meyerml/Studienarbeit/readme.md

# ESP-basierte Funkklingel

In diesem Projekt werden verschiedene ESP32-basierte Hardwareplattformen auf minimalen Deep-Sleep-Strom getestet. Einige Modifizierungen wurden an den Hardwareplattformen vorgenommen, um den Deep-Sleep-Strom weiter zu reduzieren. Desweiteren wurden verschiedene Wireless-Protokolle gestestet und auf ihren Energieverbrauch hin untersucht.

Mit diesen Tools können Mp3-Dateien für den M5Stack Atom Echo spielbar gemacht werden:

mp3 -> pcm: https://products.aspose.app/slides/de/video/mp3-to-pcm#google\_vignette

pcm -> c Array: https://notisrac.github.io/FileToCArray/
