meyerml/Studienarbeit/deep_sleep/hardware.ods

ohne vcc supervisory circuit | 9.8
ohne led | 9.39
ohne coprozessor | 0.213
 |  | 33µA
ohne led |  | 23µA
ohne LCD driver |  | 10mA?
ohne opamp |  | 21.8
 |  |  | 469.24
ohne LED |  |  | 108.6µA
ohne sensor |  |  | 108.6µA
 |  |  | 52µA
