meyerml/Studienarbeit/wireless_protocols/boot/ppk-20260218T080058.png

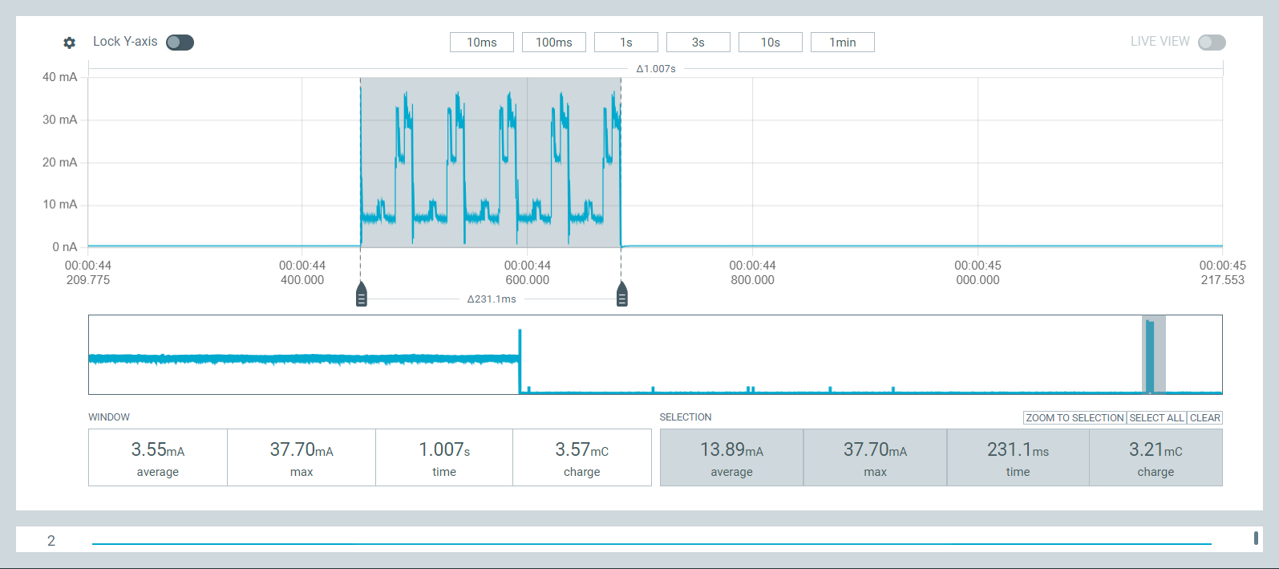
wireless_protocols/boot/ppk-20260218T080058.png
