meyerml/Studienarbeit/wireless_protocols/boot_wifi/ppk-20260218T075423.png

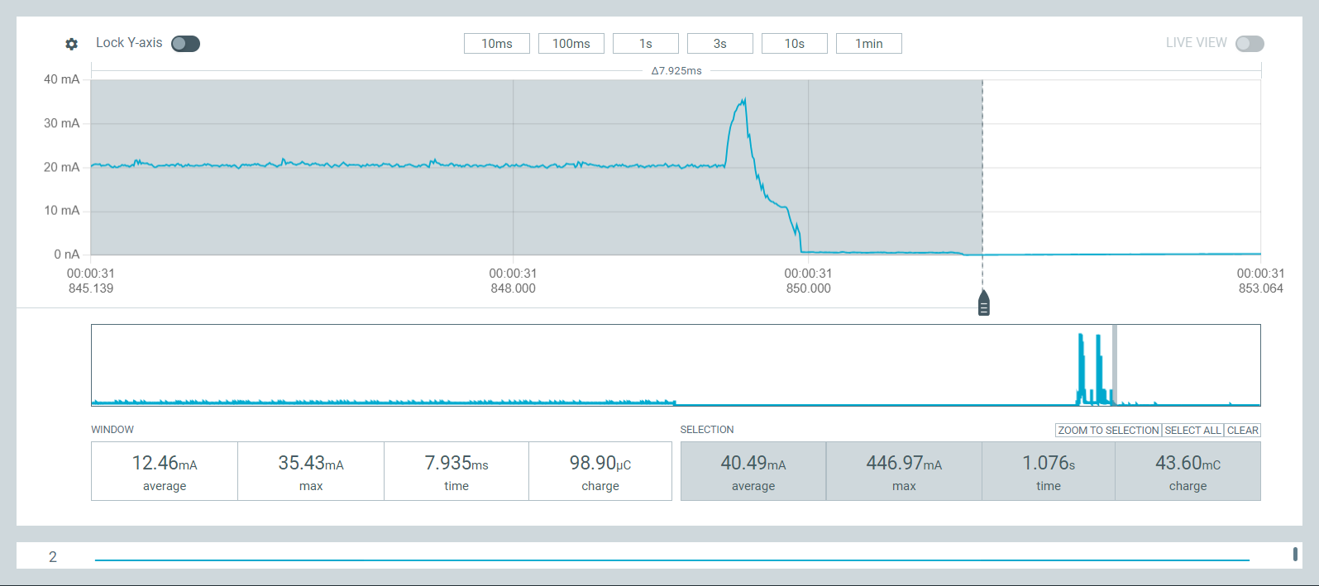
wireless_protocols/boot_wifi/ppk-20260218T075423.png
