meyerml/Studienarbeit/wireless_protocols/current_consumption_plot.png

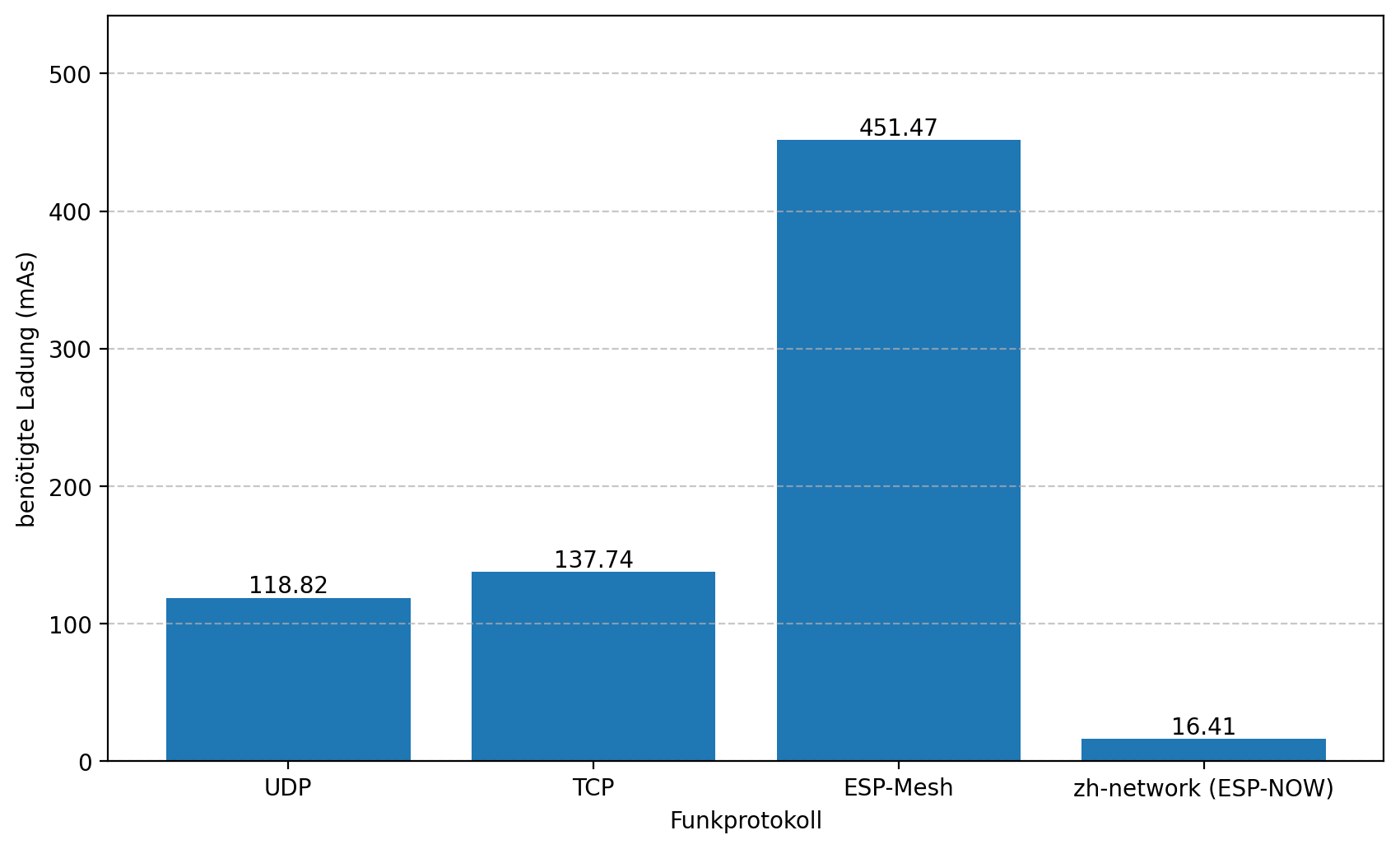
wireless_protocols/current_consumption_plot.png
