meyerml/Studienarbeit/wireless_protocols/ESP-Mesh/ppk-20260211T094203.png

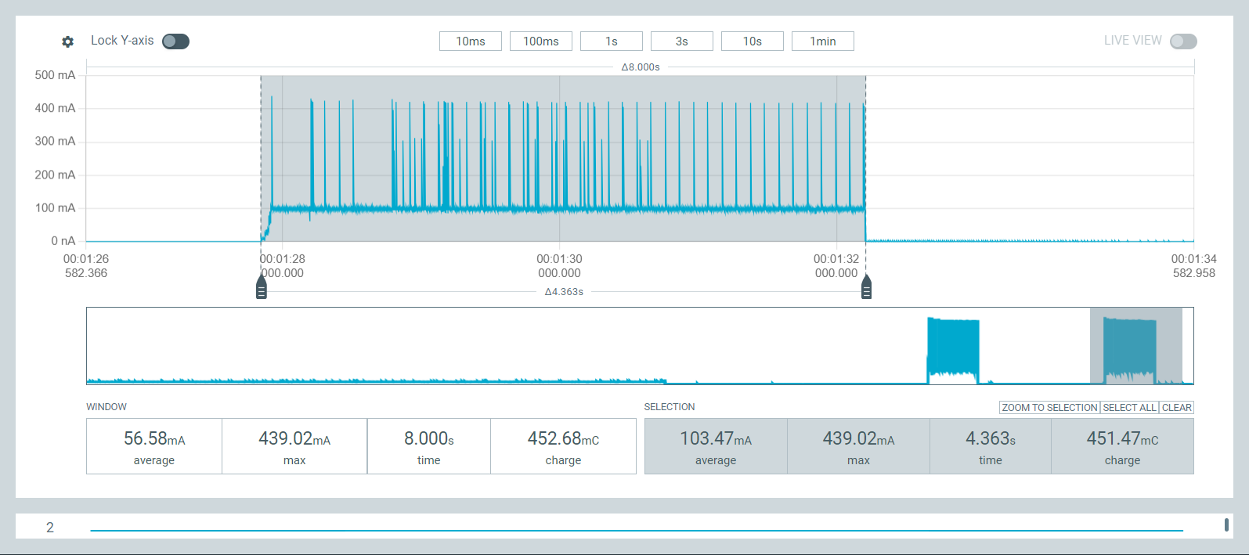
wireless_protocols/ESP-Mesh/ppk-20260211T094203.png
