meyerml/Studienarbeit/wireless_protocols/plot.png

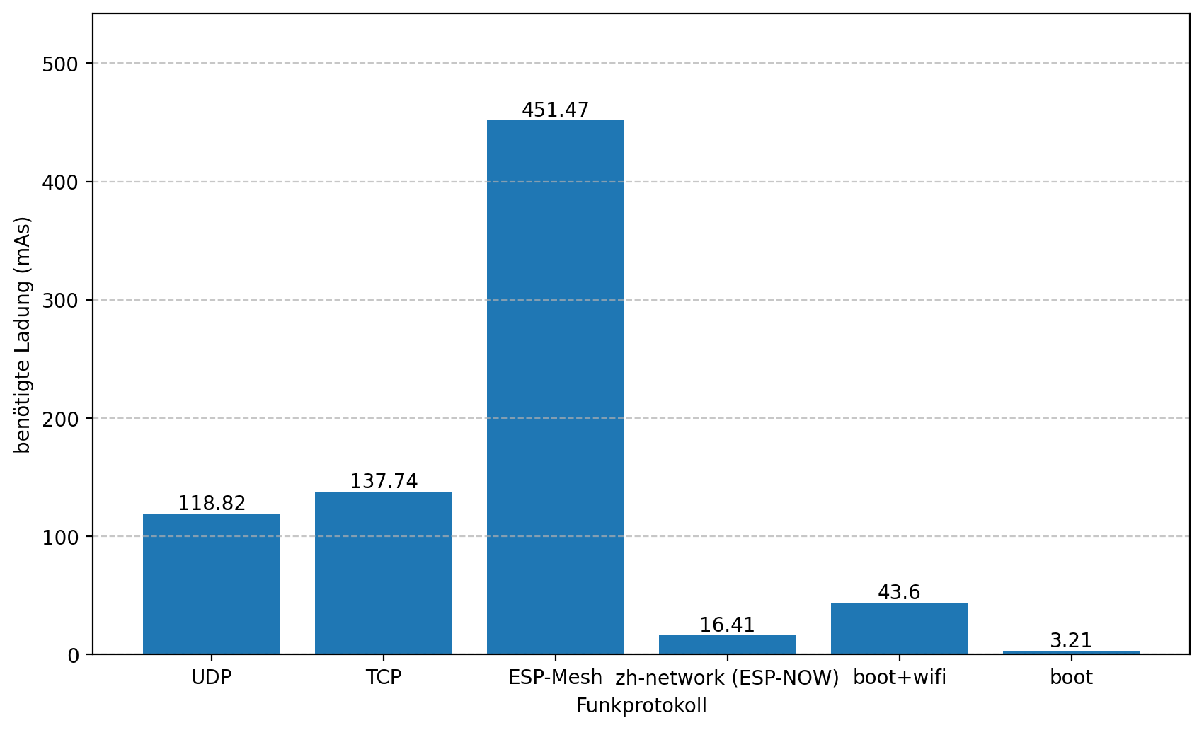
wireless_protocols/plot.png
