meyerml/Studienarbeit/wireless_protocols/TCP/ppk-20260210T215253.png

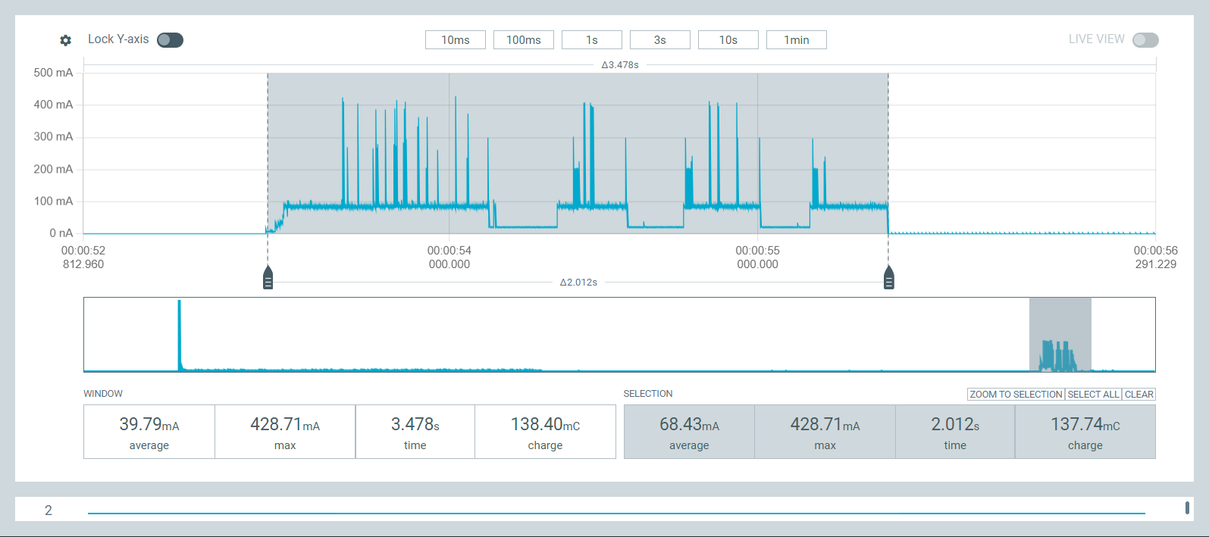
wireless_protocols/TCP/ppk-20260210T215253.png
