meyerml/Studienarbeit/wireless_protocols/UDP/sending.png

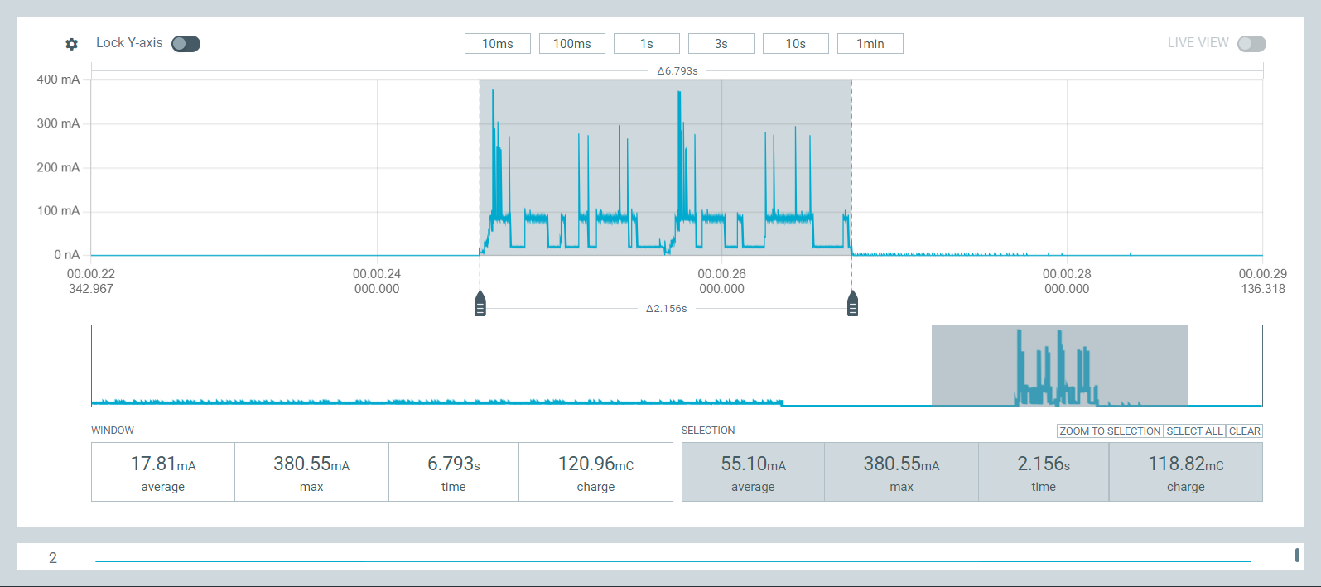
wireless_protocols/UDP/sending.png
