meyerml/Studienarbeit/wireless_protocols/measurements.ods

 | atom lite | codecell
deep sleep current
 | thread | zigbee | udp | tcp | Esp-mesh | Esp-now mesh | only boot + wifi | only boot
charge for sending ring | 207.49 | 55.82mC | 118.82mC | 137.74mC | 451.47mC | 16.41mC | 43.6mC | 3.21mC
