meyerml/Studienarbeit/deep_sleep/deep_sleep_baseline_measurements/atom/deepsleepcurrent.png

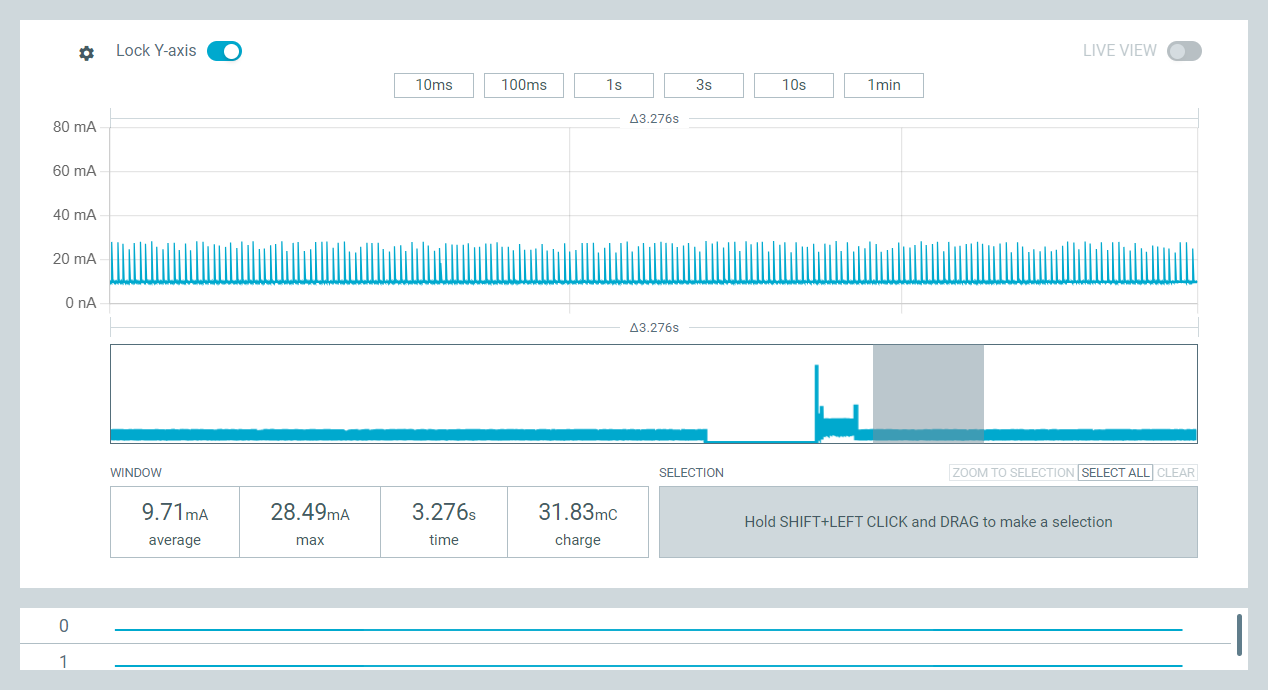
deep_sleep/deep_sleep_baseline_measurements/atom/deepsleepcurrent.png
