meyerml/Studienarbeit/deep_sleep/deep_sleep_baseline_measurements/atom/deepsleepcurrent_vs_nondeepsleep.png

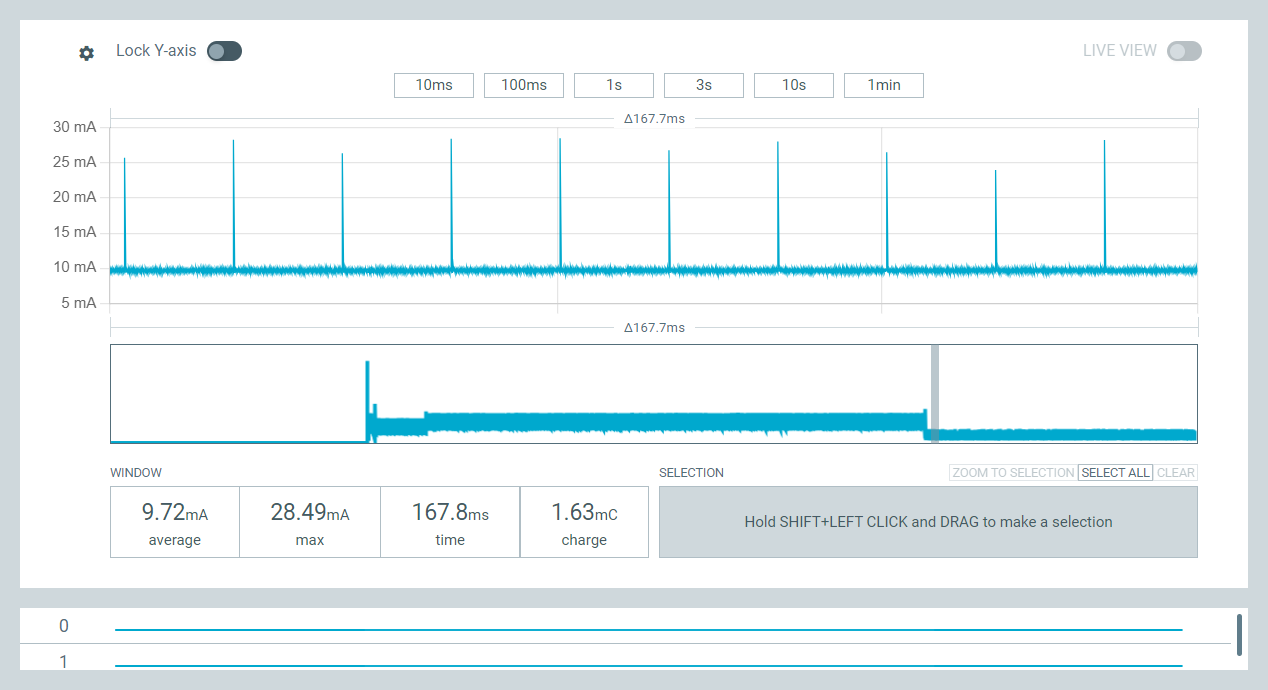
deep_sleep/deep_sleep_baseline_measurements/atom/deepsleepcurrent_vs_nondeepsleep.png
