meyerml/Studienarbeit/deep_sleep/deep_sleep_baseline_measurements/atom/nondeepsleep_detail.png

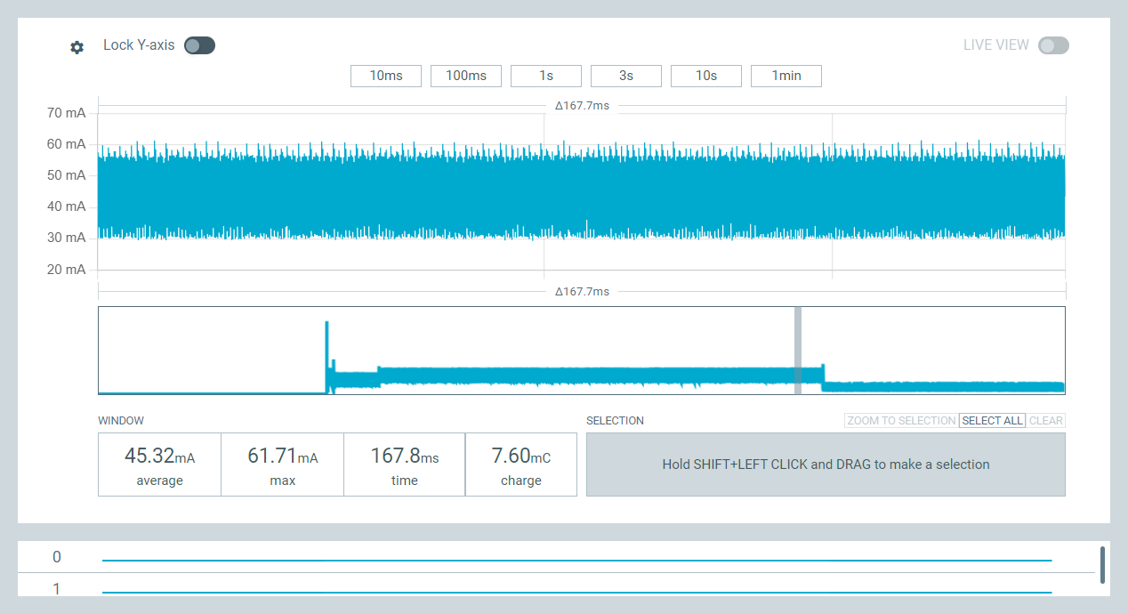
deep_sleep/deep_sleep_baseline_measurements/atom/nondeepsleep_detail.png
