meyerml/Studienarbeit/deep_sleep/deep_sleep_baseline_measurements/codecell.png

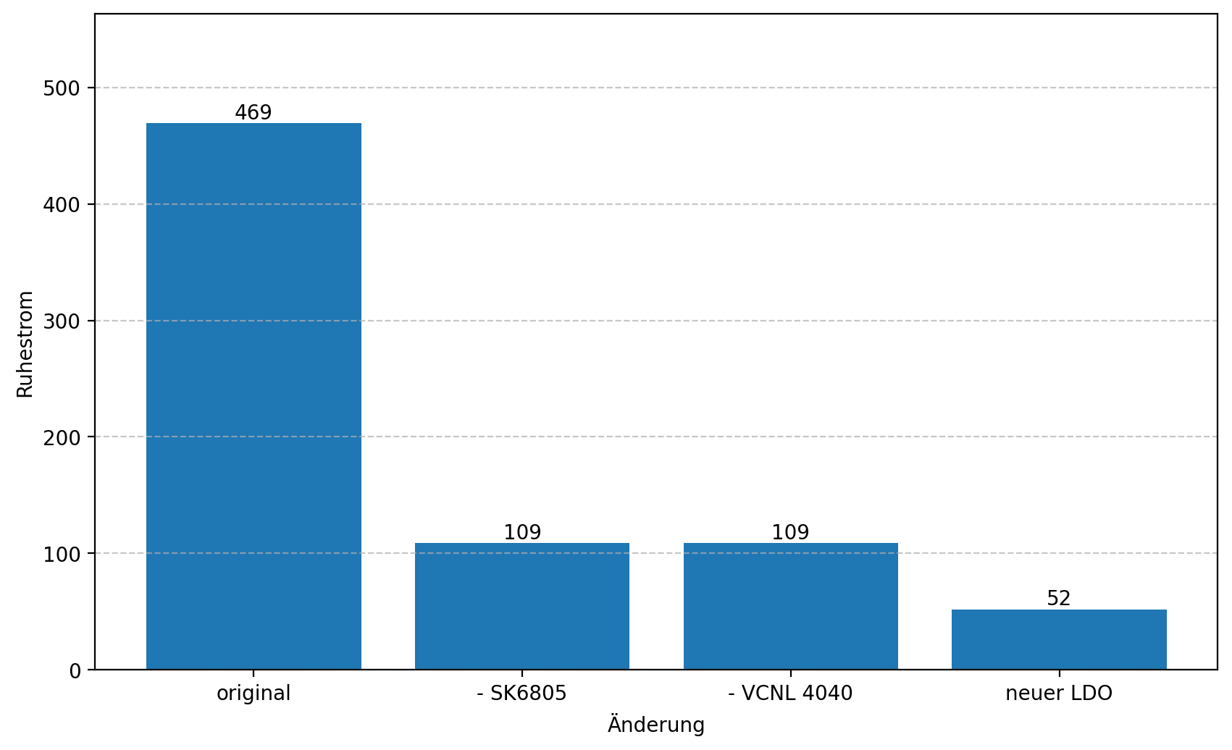
deep_sleep/deep_sleep_baseline_measurements/codecell.png
