meyerml/Studienarbeit/deep_sleep/deep_sleep_baseline_measurements/codecell/bareminimum/definitelynotdeepsleep.png

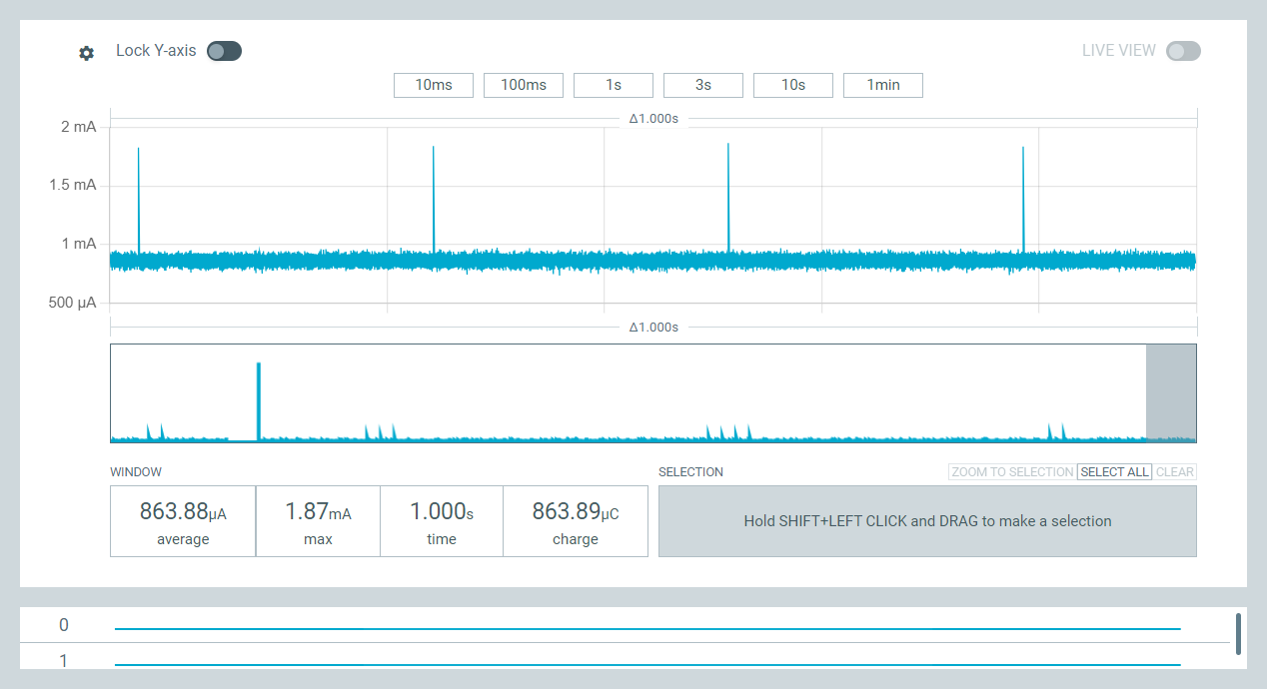
deep_sleep/deep_sleep_baseline_measurements/codecell/bareminimum/definitelynotdeepsleep.png
