meyerml/Studienarbeit/deep_sleep/deep_sleep_baseline_measurements/codecell/externalWakeUp3_3VVin/dontwork.png

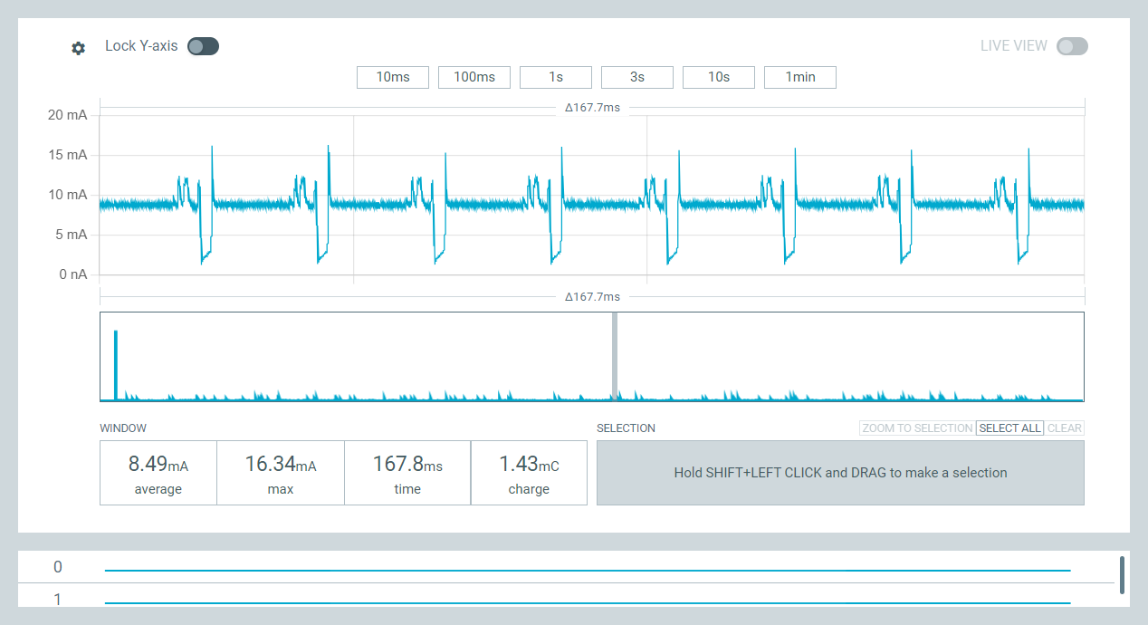
deep_sleep/deep_sleep_baseline_measurements/codecell/externalWakeUp3_3VVin/dontwork.png
