meyerml/Studienarbeit/deep_sleep/deep_sleep_baseline_measurements/codecell/externalWakeUp4_2VBat/beforedeepsleep.png

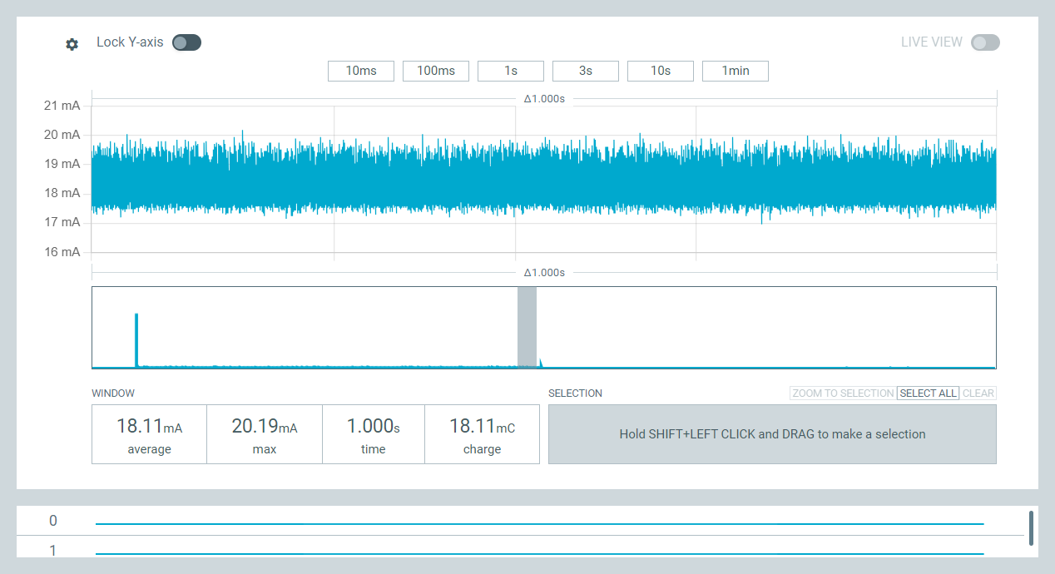
deep_sleep/deep_sleep_baseline_measurements/codecell/externalWakeUp4_2VBat/beforedeepsleep.png
