meyerml/Studienarbeit/deep_sleep/deep_sleep_baseline_measurements/codecell/ExternalWakeUp/deepsleepcurrentmaybe.png

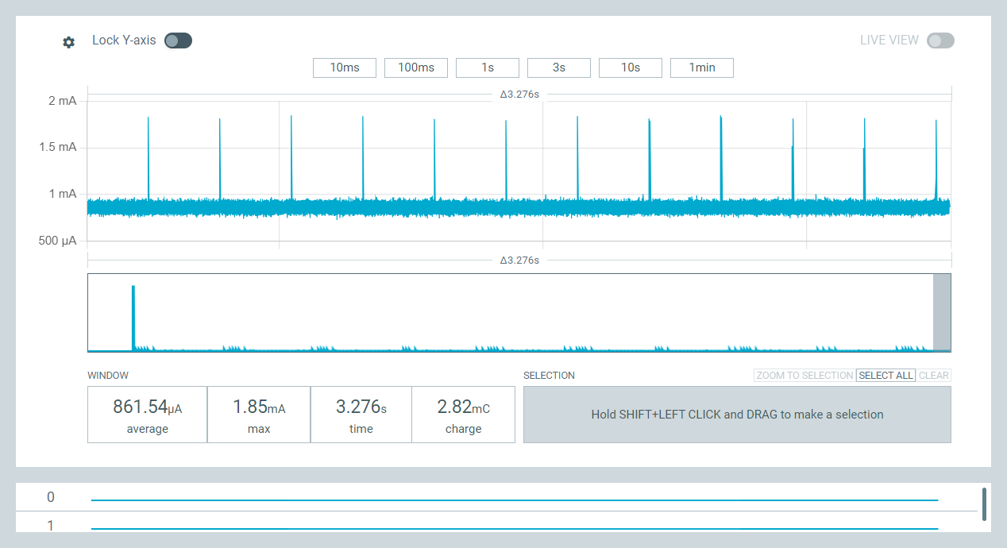
deep_sleep/deep_sleep_baseline_measurements/codecell/ExternalWakeUp/deepsleepcurrentmaybe.png
