meyerml/Studienarbeit/deep_sleep/deep_sleep_baseline_measurements/deepsleepcurrent.png

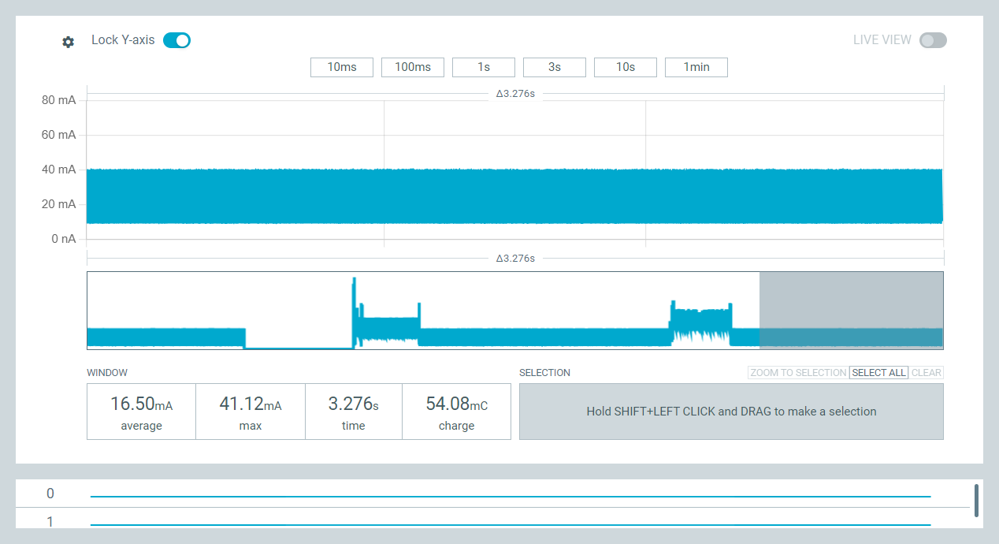
deep_sleep/deep_sleep_baseline_measurements/deepsleepcurrent.png
