meyerml/Studienarbeit/wireless_protocols/deep_sleep/deep_sleep_baseline_measurements/current_consumption_plot.png

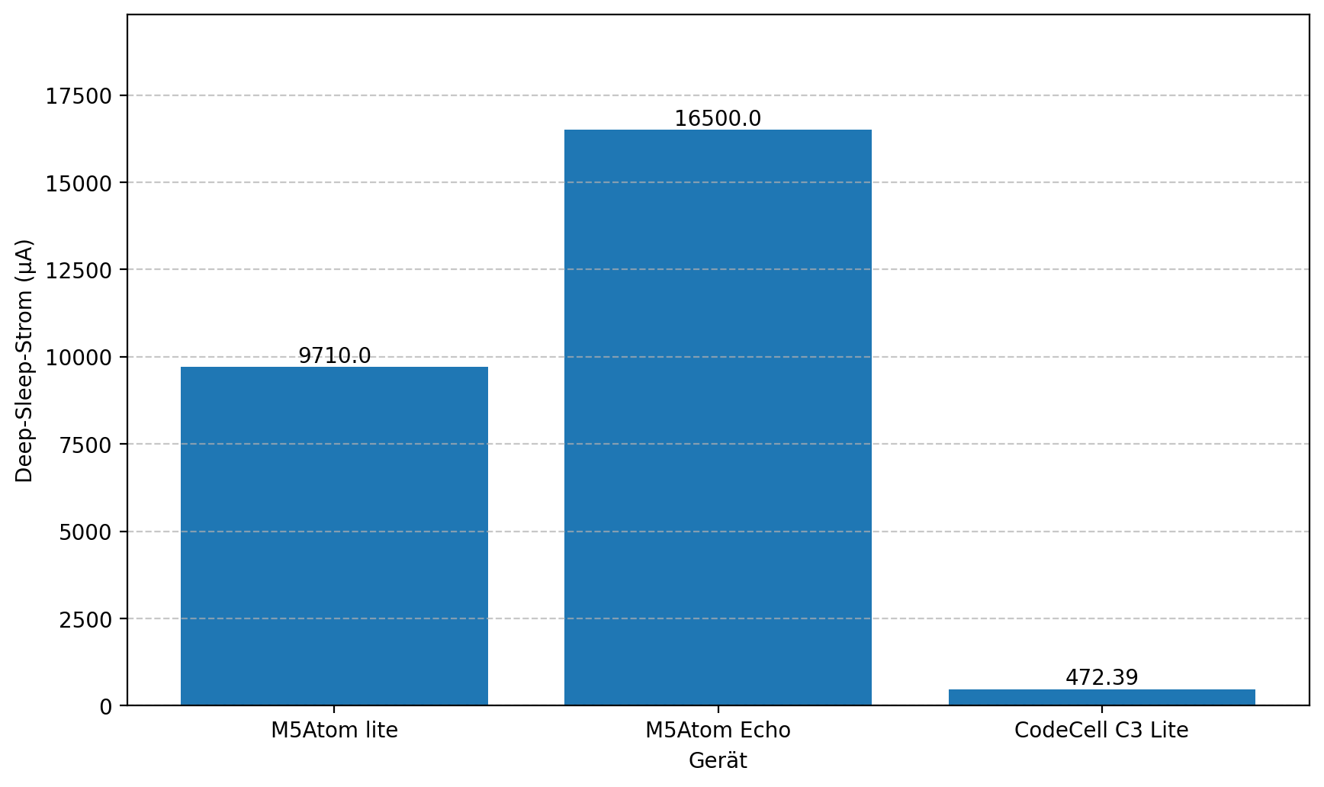
wireless_protocols/deep_sleep/deep_sleep_baseline_measurements/current_consumption_plot.png
