meyerml/Studienarbeit/wireless_protocols/thread/switch/switch.ino

// Copyright 2024 Espressif Systems (Shanghai) PTE LTD
//
// Licensed under the Apache License, Version 2.0 (the "License");
// you may not use this file except in compliance with the License.
// You may obtain a copy of the License at

//     http://www.apache.org/licenses/LICENSE-2.0
//
// Unless required by applicable law or agreed to in writing, software
// distributed under the License is distributed on an "AS IS" BASIS,
// WITHOUT WARRANTIES OR CONDITIONS OF ANY KIND, either express or implied.
// See the License for the specific language governing permissions and
// limitations under the License.

#include "OThreadCLI.h"
#include "OThreadCLI_Util.h"

#define USER_BUTTON           GPIO_NUM_3  // C6/H2 Boot button
#define OT_CHANNEL            "24"
#define OT_NETWORK_KEY        "00112233445566778899aabbccddeeff"
#define OT_MCAST_ADDR         "ff05::abcd"
#define OT_COAP_RESOURCE_NAME "Lamp"

const char *otSetupChild[] = {
  // -- clear/disable all
  // stop CoAP
  "coap", "stop",
  // stop Thread
  "thread", "stop",
  // stop the interface
  "ifconfig", "down",
  // clear the dataset
  "dataset", "clear",
  // -- set dataset
  // set the channel
  "dataset channel", OT_CHANNEL,
  // set the network key
  "dataset networkkey", OT_NETWORK_KEY,
  // commit the dataset
  "dataset", "commit active",
  // -- network start
  // start the interface
  "ifconfig", "up",
  // start the Thread network
  "thread", "start"
};

const char *otCoapSwitch[] = {
  // -- start CoAP as client
  "coap", "start"
};

bool otDeviceSetup(
  const char **otSetupCmds, uint8_t nCmds1, const char **otCoapCmds, uint8_t nCmds2, ot_device_role_t expectedRole1, ot_device_role_t expectedRole2
) {
  Serial.println("Starting OpenThread.");
  Serial.println("Running as Switch - use the BOOT button to toggle the other C6/H2 as a Lamp");
  uint8_t i;
  for (i = 0; i < nCmds1; i++) {
    if (!otExecCommand(otSetupCmds[i * 2], otSetupCmds[i * 2 + 1])) {
      break;
    }
  }
  if (i != nCmds1) {
    log_e("Sorry, OpenThread Network setup failed!");
    //rgbLedWrite(RGB_BUILTIN, 255, 0, 0);  // RED ... failed!
    return false;
  }
  Serial.println("OpenThread started.\r\nWaiting for activating correct Device Role.");
  // wait for the expected Device Role to start
  uint8_t tries = 24;  // 24 x 2.5 sec = 1 min
  
  while (tries && OThread.otGetDeviceRole() != expectedRole1 && OThread.otGetDeviceRole() != expectedRole2) {
    Serial.print(".");
    delay(2500);
    tries--;
  }
  Serial.println();
  if (!tries) {
    log_e("Sorry, Device Role failed by timeout! Current Role: %s.", OThread.otGetStringDeviceRole());
    //rgbLedWrite(RGB_BUILTIN, 255, 0, 0);  // RED ... failed!
    return false;
  }
  Serial.printf("Device is %s.\r\n", OThread.otGetStringDeviceRole());
  for (i = 0; i < nCmds2; i++) {
    if (!otExecCommand(otCoapCmds[i * 2], otCoapCmds[i * 2 + 1])) {
      break;
    }
  }
  if (i != nCmds2) {
    log_e("Sorry, OpenThread CoAP setup failed!");
    //rgbLedWrite(RGB_BUILTIN, 255, 0, 0);  // RED ... failed!
    return false;
  }
  Serial.println("OpenThread setup done. Node is ready.");
  // all fine! LED goes and stays Blue
  ///rgbLedWrite(RGB_BUILTIN, 0, 0, 64);  // BLUE ... Switch is ready!
  return true;
}

void setupNode() {
  // tries to set the Thread Network node and only returns when succeeded
  bool startedCorrectly = false;
  while (!startedCorrectly) {
    startedCorrectly |= otDeviceSetup(
      otSetupChild, sizeof(otSetupChild) / sizeof(char *) / 2, otCoapSwitch, sizeof(otCoapSwitch) / sizeof(char *) / 2, OT_ROLE_CHILD, OT_ROLE_ROUTER
    );
    if (!startedCorrectly) {
      Serial.println("Setup Failed...\r\nTrying again...");
    }
  }
}

// Sends the CoAP frame to the Lamp node
bool otCoapPUT(bool lampState) {
  bool gotDone = false, gotConfirmation = false;
  String coapMsg = "coap put ";
  coapMsg += OT_MCAST_ADDR;
  coapMsg += " ";
  coapMsg += OT_COAP_RESOURCE_NAME;
  coapMsg += " con 0";

  // final command is "coap put ff05::abcd Lamp con 1" or "coap put ff05::abcd Lamp con 0"
  if (lampState) {
    coapMsg[coapMsg.length() - 1] = '1';
  }
  OThreadCLI.println(coapMsg.c_str());
  log_d("Send CLI CMD:[%s]", coapMsg.c_str());

  char cliResp[256];
  // waits for the CoAP confirmation and Done message for about 1.25 seconds
  // timeout is based on Stream::setTimeout()
  // Example of the expected confirmation response: "coap response from fdae:3289:1783:5c3f:fd84:c714:7e83:6122"
  uint8_t tries = 5;
  *cliResp = '\0';
  while (tries && !(gotDone && gotConfirmation)) {
    size_t len = OThreadCLI.readBytesUntil('\n', cliResp, sizeof(cliResp));
    cliResp[len - 1] = '\0';
    log_d("Try[%d]::MSG[%s]", tries, cliResp);
    if (strlen(cliResp)) {
      if (!strncmp(cliResp, "coap response from", 18)) {
        gotConfirmation = true;
      }
      if (!strncmp(cliResp, "Done", 4)) {
        gotDone = true;
      }
    }
    tries--;
  }
  if (gotDone && gotConfirmation) {
    return true;
  }
  return false;
}

// this function is used by the Switch mode to check the BOOT Button and send the user action to the Lamp node
void checkUserButton() {
  static long unsigned int lastPress = 0;
  const long unsigned int debounceTime = 500;
  static bool lastLampState = true;  // first button press will turn the Lamp OFF from initial Green

  pinMode(USER_BUTTON, INPUT_PULLUP);  // C6/H2 User Button
  //Serial.println(digitalRead(USER_BUTTON));
  if (millis() > lastPress + debounceTime && digitalRead(USER_BUTTON) == LOW) {
    lastLampState = !lastLampState;
    if (!otCoapPUT(lastLampState)) {  // failed: Lamp Node is not responding due to be off or unreachable
      // timeout from the CoAP PUT message... restart the node.
      //rgbLedWrite(RGB_BUILTIN, 255, 0, 0);  // RED ... something failed!
      Serial.println("Resetting the Node as Switch... wait.");
      // start over...
      setupNode();
    } else {
      Serial.println("did it");
    }
    lastPress = millis();
  }
}

void setup() {
  Serial.begin(115200);
  // LED starts RED, indicating not connected to Thread network.
  //rgbLedWrite(RGB_BUILTIN, 64, 0, 0);
  OThread.begin(false);  // No AutoStart is necessary
  OThreadCLI.begin();
  OThreadCLI.setTimeout(250);  // waits 250ms for the OpenThread CLI response
  setupNode();
  // LED goes and keeps Blue when all is ready and Red when failed.
}

void loop() {
  checkUserButton();
  delay(10);
}
