meyerml/Studienarbeit/wireless_protocols/TCP/deep_sleep_klingelknopf_tcp/deep_sleep_klingelknopf_tcp.ino

//for codecell

//#define DEBUG
//#undef DEBUG


#include <WiFi.h>
//#include <WiFiUdp.h>
#include "driver/rtc_io.h"

#define BUTTON_PIN_BITMASK(GPIO) (1ULL << GPIO)  // 2 ^ GPIO_NUMBER in hex
#define WAKEUP_GPIO              GPIO_NUM_5     // Only RTC IO are allowed - ESP32 Pin example
//#define AWAKE_SIGNAL             GPIO_NUM_2
//#define SENDING_SIGNAL           7
bool button_pressed = false;

/* WiFi network name and password */
const char *ssid = "POCOPHONE";
const char *pwd = "testtest";
// IP address to send UDP data to.
// it can be ip address of the server or 
// a network broadcast address
// here is broadcast address
//const char * udpAddress = "10.198.130.147";
//const char * broadcastAddress = "10.198.130.255";
//10.117.115.216
const char * tcpAddress = "10.117.115.216";

const int tcpPort = 8080;



WiFiClient client;


void handle_wakeup_reason() {
  esp_sleep_wakeup_cause_t wakeup_reason;

  wakeup_reason =  esp_sleep_get_wakeup_cause();
  //Serial.print("Wakeup cause: ");
  //Serial.println(wakeup_reason);

  switch (wakeup_reason) {
    case 7:{
      #ifdef DEBUG
      delay(2000);
      Serial.println("Wakeup caused by external signal using RTC_CNTL");
      #endif
      button_pressed = true;
      break;
    }     
    default:  {
      #ifdef DEBUG                      
      Serial.printf("Wakeup was not caused by deep sleep: %d\n", wakeup_reason);
      #endif 
      delay(20000);  //allow for flashing
      //digitalWrite(AWAKE_SIGNAL, true);
      //delay(1000);
      break;
    }
  }
}

void ring_bell(){

    //Connect to the WiFi network
    WiFi.begin(ssid, pwd);
        // Wait for connection
    while (WiFi.status() != WL_CONNECTED) {
      delay(100);
      #ifdef DEBUG
      Serial.print(".");
      #endif
    }


    if (!client.connected()) {
      #ifdef DEBUG
      Serial.println("Connecting to server...");
      #endif
      if (client.connect(tcpAddress, tcpPort)) {
        #ifdef DEBUG
        Serial.println("Connected, sending string!");
        #endif
        client.println("RING");
        delay(1000);
      } else {
        #ifdef DEBUG
        Serial.println("Connection failed!");
        #endif
        return;
      }
    }
  }

void setup() {
  //pinMode(AWAKE_SIGNAL, OUTPUT);
  //digitalWrite(AWAKE_SIGNAL, false);

  //pinMode(SENDING_SIGNAL, OUTPUT);
  #ifdef DEBUG
  Serial.begin(115200);
  delay(1000);  //Take some time to open up the Serial Monitor
  #endif
  //Increment boot number and print it every reboot

  //delay(20000);
  gpio_set_pull_mode(WAKEUP_GPIO, GPIO_PULLDOWN_ONLY);
  //Print the wakeup reason for ESP32
  handle_wakeup_reason();

  if(button_pressed){

    //digitalWrite(AWAKE_SIGNAL, false);
    ring_bell();
    //send udp packet
  }

  esp_deep_sleep_enable_gpio_wakeup(BUTTON_PIN_BITMASK(WAKEUP_GPIO), ESP_GPIO_WAKEUP_GPIO_HIGH);

  //esp_sleep_enable_ext1_wakeup(BUTTON_PIN_BITMASK(WAKEUP_GPIO), ESP_EXT1_WAKEUP_ALL_LOW);
  //gpio_pulldown_en(WAKEUP_GPIO);  // GPIO33 is tie to GND in order to wake up in HIGH
  //gpio_pullup_dis(AWAKE_SIGNAL);  // GPIO33 is tie to GND in order to wake up in HIGH

  //rtc_gpio_pullup_dis(WAKEUP_GPIO);   // Disable PULL_UP in order to allow it to wakeup on HIGH
  //Go to sleep now
  #ifdef DEBUG
  Serial.println("Going to sleep now");
  delay(1000);
  #endif
  //digitalWrite(AWAKE_SIGNAL, true);
  //delay(10);
  esp_deep_sleep_start();
}

void loop() {
  //This is not going to be called
}
