meyerml/Studienarbeit/(commit log)

2026-03-27 first upload
    [hardware.ods, measurements.ods]
2026-03-27 upload atomic battery base charging curve
    [charging.ods]
